tuskeshatu/silabs-thermonkey/doc/THERMOnkey doc.pdf

# Silicon Labs HackathON

## Okosotthon, de mi van ha Te vagy az okosabb

## THERMOnkey

Az okos hőmérsékleti megoldás.

## Csapattagok:

## Csuta Krisztián, Kovács Levente, Mészáros Bálint

## Villamosmérnök BSc Budapesti Műszaki és Gazdaságtudományi Egyetem

2025. szeptember 14.

## Projekt bemutatása

A THERMOnkey egy okos hőmérséklet-figyelő, illetve szabályozó rendszer, amely vezeték nélküli kommunikációval képes adatokat továbbítani és megjeleníteni. A projekt célja egy könnyen használható, megbízható és bővíthető megoldás létrehozása volt, amely otthoni vagy akár ipari környezetben is alkalmazható. A projekt GitHub repositoryja ide kattintva érhető el: https://github.com/tuskeshatu/silabs-thermonkey.

## Rendszer felépítése

Okosotthon-képes termosztát vezérlőegység

A vezérlőegységet egy MG24 dev-kit segítségével valósítottuk meg.

Matter és okosotthon?

A rendszer egyik fő előnye, hogy könnyedén integrálható különböző okosotthon platformokkal, a Matter over Thread protokoll támogatásával. Ezt szoftveresen a Silabs Arduino core-ba integrált Matter API segítségével könnyedén megvalósíthattuk. Az eszközt indításkor commission-ölni kell egy Matter hálózatba, utána pedig intuitívan és egyszerűen, akár távolról is vezérelhető (mint bármilyen egyéb okosotthon képes termosztát). Mi ennek a tesztelését Apple home környezetben valósítottuk meg.


1. ábra. Apple home környezetben a THERmonkey termosztát

Ház és kijelző
A falra szerelhető, 3D nyomtatott dobozban helyet kapott egy Adafruit 0.96" 160x80 Color TFT kijelző, melyen kezdetkor megjelenik a Matter párosításhoz szükséges kód. Ez elengedhetetlen a felhasználóbarát működéshez. Miután a termosztát integrálva lett egy okosotthon környezetbe, a képernyő felváltva a fejlesztőboard beépített szenzorja által mért, jelenlegi hőmérsékletet, illetve a Matter-ön keresztül kapott beállított hőmérsékletet írja ki. A megjelenítéshez a kijelzőhöz tartotó Arduino library-t használtuk (megj.: ez egyáltalán nem bizonyult intuitívnak, vagy egyszerűnek).


2. ábra. A termosztát ház 3D modellje

Hőmérsékletszabályozást megvalósító vezeték nélküli termofej


A termofejet a MG24 explorer-kit boardja hajtja meg. Ezeknek a végső radiátorra szerelhetősége két problémát vet fel: az egyik az áramellátás, a másik a vezérléshez szükséges információátadás.

Áramellátás

Az eredeti tervek szerint az áramellátást egy lecsatlakoztatható akkumulátorral oldottuk volna meg, ám realizáltuk, hogy custom akkumulátorpakkok nélkül a limitált méret miatt ez fizikai képtelenség lenne. A végső megoldásunkban 4db 1.5 V-os, AA-s elem került beépítésre a házba.
Annak érdekében, hogy az eszköz minél lasabban merüljön, drasztikus fogyasztáscsökkentést kellett elérnünk. Az alábbi táblázatban láthatóak az elérhető nagyszerű és az Arduino Low Power library segítségével egyszerűen vezérelhető energia állapotai a boardnak.
Energy Mode | Description | Power Consumption
EM0 – Run | CPU aktív, utasításokat hajt végre Flash-ből vagy RAM-ból; minden alacsony energia periféria engedélyezhető. | 180 µA/MHz
EM1 – Sleep | CPU órajel leáll, de RAM és perifériák működnek; PRS és DMA révén CPU beavatkozás nélkül dolgozhat. | 45 µA/MHz
EM2 – Deep Sleep | Nagyfrekvenciás oszcillátor kikapcsolva, de 32 kHz óra és RTC elérhető; CPU nem fut, RAM megtartva. | 0.9 µA
EM3 – Stop | Alacsony frekvenciás oszcillátor kikapcsolva; RAM megtartva; analóg komparátor vagy külső megszakítás ébreszthet. | 0.6 µA
EM4 – Shutoff | MCU teljesen leáll; nincs RTC vagy RAM megtartás. Csak reset vagy külső megszakítás ébreszti. | 20 nA
1. táblázat. EFM32 energia módok összehasonlítása (kiemelve az EM4 tulajdonságai).

Ezek alapján egyértelműen látszik, hogy miért választottuk a szinte teljes kikapcsolását a boardnak. Mivel egy szonának a hőtehetetlensége szerencsére elég nagy, ezért szoftverben egyszerűen vezérelhető módon úgy programoztuk ezeket, hogy csak időnként ébredjenek fel, kérdezzék meg a termosztátot, hogy hány fok van és mennyinek kéne lennie, majd visszaalszanak (, vagyis sleepy end deviceok). Ezzel sikerült elérni, hogy gyakorlatilag amikor nem történik aktív vezérlés, akkor nincs áramfogyasztás sem.

Vezeték nélküli kommunikáció

A fentebb említett energiafelhasználási megkötések és az egyszerűség kedvéért a megoldásunk Bluetooth Low Energy (BLE) technológiát használ a termosztát és a termofejek közötti kommunikációra. A termosztát egy always-on BLE szerverként viselkedik, amire az éppen aktuálisan felébredő termofej kliensként felcsatlakozik, majd miután megkapta a hőmérsékleti adatokat elmegy alacsony fogyasztású üzemmódba. Amennyiben egy ideig nem sikerült a termofejnek csatlakozni a BLE szerverhez (termosztáthoz), abban az esetben timeout-ol és szintén visszamegy aludni. Fontos, hogy a timeout időt megfelelően hosszúra válasszuk, hogy mindegyik termofej sorra kerüljön.

Mechanikai megoldások

A radiátoron található csavar elcsavarásához szükséges viszonylag nagy nyomaték miatt a designban helyet kapott egy 1:4 áttétű fogaskerék rendszer is. Egy Adafruit MOS-FET Driverrel meghajtott DC motor tengelye csatlakozik a kisebb fogaskerékre, míg a nagyobb fogaskerék közvetlenül ráilleszthető a standard csavarra a radiátoron.


3. ábra. A fogaskerekek (1:4 áttét)

## Amire a legbüszkébbek vagyunk

Különösen büszkék vagyunk arra, hogy sikerült stabil és megbízható Matter és BLE kommunikációt kialakítani. Mivel a Matter is használja a BLE stacket és funkcionalitásokat, ezért a két funkcionalitás (termofej-termosztát és termosztát-Matter hub kommunikáció) együttes, egymást nem zavaró és kizáró megvalósítása nem volt egyszerű feladat.
A rendszer energiahatékonysága és az ezzel összeegyeztethetetlen (kis méret, vezeték nélküliség) követelmények az eszköz iránt is kiemelkedően sok fejvakarást okoztak. Az alacsony energiafogyasztású állapotban mivel szinte semmilyen periféria nem működik, ezért egy működőképes konstrukció kitalálása az okosotthonba integrálhatósághoz nehéz feladat.
A különböző perifériák kezelése közül külön említést érdemel az Adafruit 0.96" 160x80 Color TFT kijelző, melynek a könyvtára által adott édes lehetőségek tengere annyira elárasztott bennünket, hogy a kód kellemetlenül nagy részét kiteszi a megjelenítés. Jónéhány sor csak azért felel, hogy a ° karaktert megjelenítsük.
Összességében a projekt során nemcsak szakmai tudásunkat bővítettük, hanem megtapasztaltuk a közös munka örömét és a problémamegoldás izgalmát is. A végeredmény egy működő, hasznos és (mind szoftveresen és hardveresen) egyszerűen bővíthető rendszer lett, amelyre mindannyian büszkék vagyunk.
