tuskeshatu/silabs-thermonkey/(commit log)

2025-09-12 fix matter commissioning and ble conflict
    [thermostat.ino]
2025-09-14 Add motor control
2025-09-14 fix set_temp declaration in updateTFT()
    [thermostat.ino]
2025-09-14 set motor on time
